embedded-kiddie/MLX90640/heatmap.h

#if   (N_HEATMAP == 256)
{
/* Railbow */
0x480F,0x400F,0x400F,0x400F,0x4010,0x3810,0x3810,0x3810,0x3810,0x3010,0x3010,0x3010,0x2810,0x2810,0x2810,0x2810,
0x2010,0x2010,0x2010,0x1810,0x1810,0x1811,0x1811,0x1011,0x1011,0x1011,0x0811,0x0811,0x0811,0x0011,0x0011,0x0011,
0x0011,0x0011,0x0031,0x0031,0x0051,0x0072,0x0072,0x0092,0x00B2,0x00B2,0x00D2,0x00F2,0x00F2,0x0112,0x0132,0x0152,
0x0152,0x0172,0x0192,0x0192,0x01B2,0x01D2,0x01F3,0x01F3,0x0213,0x0233,0x0253,0x0253,0x0273,0x0293,0x02B3,0x02D3,
0x02D3,0x02F3,0x0313,0x0333,0x0333,0x0353,0x0373,0x0394,0x03B4,0x03D4,0x03D4,0x03F4,0x0414,0x0434,0x0454,0x0474,
0x0474,0x0494,0x04B4,0x04D4,0x04F4,0x0514,0x0534,0x0534,0x0554,0x0554,0x0574,0x0574,0x0573,0x0573,0x0573,0x0572,
0x0572,0x0572,0x0571,0x0591,0x0591,0x0590,0x0590,0x058F,0x058F,0x058F,0x058E,0x05AE,0x05AE,0x05AD,0x05AD,0x05AD,
0x05AC,0x05AC,0x05AB,0x05CB,0x05CB,0x05CA,0x05CA,0x05CA,0x05C9,0x05C9,0x05C8,0x05E8,0x05E8,0x05E7,0x05E7,0x05E6,
0x05E6,0x05E6,0x05E5,0x05E5,0x0604,0x0604,0x0604,0x0603,0x0603,0x0602,0x0602,0x0601,0x0621,0x0621,0x0620,0x0620,
0x0620,0x0620,0x0E20,0x0E20,0x0E40,0x1640,0x1640,0x1E40,0x1E40,0x2640,0x2640,0x2E40,0x2E60,0x3660,0x3660,0x3E60,
0x3E60,0x3E60,0x4660,0x4660,0x4E60,0x4E80,0x5680,0x5680,0x5E80,0x5E80,0x6680,0x6680,0x6E80,0x6EA0,0x76A0,0x76A0,
0x7EA0,0x7EA0,0x86A0,0x86A0,0x8EA0,0x8EC0,0x96C0,0x96C0,0x9EC0,0x9EC0,0xA6C0,0xAEC0,0xAEC0,0xB6E0,0xB6E0,0xBEE0,
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
0xF6E8,0xF708,0xF709,0xF709,0xF709,0xF709,0xF729,0xF729,0xF729,0xF72A,0xF74A,0xF74A,0xF74A,0xF74A,0xF74A,0xF76A,
},
#else
#error  'N_HEATMAP' in 'MLX90649' needs to be set correctly
#endif
