embedded-kiddie/MLX90640/widgets.h

/*--------------------------------------------------------------------------------
 * Screen - Main
 *--------------------------------------------------------------------------------*/
// screen-main.png
// https://lang-ship.com/tools/image2data/
// RAW File Dump
static constexpr unsigned char screen_main[6105] = {
0x89, 0x50, 0x4e, 0x47, 0x0d, 0x0a, 0x1a, 0x0a, 0x00, 0x00, 0x00, 0x0d, 0x49, 0x48, 0x44, 0x52, 
0x00, 0x00, 0x01, 0x40, 0x00, 0x00, 0x00, 0xf0, 0x08, 0x02, 0x00, 0x00, 0x00, 0xfe, 0x4f, 0x2a, 
0x3c, 0x00, 0x00, 0x17, 0xa0, 0x49, 0x44, 0x41, 0x54, 0x78, 0x01, 0xec, 0x96, 0x31, 0xe8, 0xa9, 
0x61, 0x14, 0x87, 0xbf, 0x0b, 0x4c, 0xa4, 0x14, 0x83, 0x40, 0x14, 0x18, 0x45, 0x11, 0x22, 0x82, 
0x12, 0x16, 0x22, 0x83, 0xc5, 0xae, 0x14, 0xa4, 0xc4, 0x66, 0x1f, 0x59, 0x58, 0xd8, 0x94, 0x45, 
0x62, 0x90, 0x05, 0x7b, 0x89, 0x59, 0xca, 0x40, 0x0c, 0x10, 0x04, 0xf7, 0x57, 0xdf, 0x78, 0x97, 
0xff, 0xad, 0xbb, 0xdd, 0xf7, 0x19, 0xf4, 0x9e, 0x73, 0xce, 0x7b, 0x4c, 0xcf, 0x77, 0x5e, 0x8a, 
0x40, 0xf8, 0x7f, 0xf9, 0xc5, 0xa2, 0x18, 0x1c, 0xfa, 0xa8, 0xd1, 0x68, 0x1e, 0x8f, 0xc7, 0xf9, 
0x7c, 0xde, 0xef, 0xf7, 0xdf, 0xef, 0x17, 0x67, 0xa7, 0xd3, 0x49, 0xfd, 0x3d, 0x0e, 0x87, 0x03, 
0xd7, 0x7d, 0x3e, 0x1f, 0xf5, 0x07, 0x2a, 0x95, 0x6a, 0xb9, 0x5c, 0xba, 0xdd, 0x6e, 0x9c, 0x67, 
0xb3, 0xd9, 0x7c, 0x3e, 0xa7, 0x08, 0x04, 0xc2, 0x3f, 0x11, 0x58, 0xad, 0x56, 0x7f, 0x3e, 0x9f, 
0x62, 0xb1, 0xa8, 0x54, 0x2a, 0xe3, 0xf1, 0xf8, 0xfb, 0xfd, 0xae, 0x56, 0xab, 0xc8, 0xb3, 0x58, 
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
0x7f, 0xc8, 0x00, 0x61, 0x40, 0x6f, 0x99, 0x31, 0x81, 0xf7, 0x55, 0xa4, 0xff, 0xc5, 0x77, 0x00, 
0x33, 0xb5, 0xde, 0x79, 0x1a, 0x41, 0x67, 0x00, 0x00, 0x00, 0x00, 0x49, 0x45, 0x4e, 0x44, 0xae, 
0x42, 0x60, 0x82, };
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
