embedded-kiddie/MLX90640/marker.h

// icon-icon_marker0.png
// https://lang-ship.com/tools/image2data/
// RAW File Dump
static constexpr unsigned char icon_marker0[230] = {
0x89, 0x50, 0x4e, 0x47, 0x0d, 0x0a, 0x1a, 0x0a, 0x00, 0x00, 0x00, 0x0d, 0x49, 0x48, 0x44, 0x52, 
0x00, 0x00, 0x00, 0x0e, 0x00, 0x00, 0x00, 0x0e, 0x08, 0x00, 0x00, 0x00, 0x00, 0x3a, 0x23, 0x72, 
0x0d, 0x00, 0x00, 0x00, 0xad, 0x49, 0x44, 0x41, 0x54, 0x78, 0xda, 0x05, 0xc1, 0x3b, 0xd2, 0xc1, 
0x50, 0x00, 0x86, 0xe1, 0x37, 0xc1, 0x98, 0x64, 0x05, 0xfe, 0x8b, 0x0a, 0x85, 0x05, 0x30, 0x24, 
0x8d, 0x45, 0x88, 0xc9, 0x71, 0x06, 0x67, 0x23, 0x34, 0xd6, 0xa0, 0x61, 0x3f, 0x32, 0x6e, 0x05, 
0x85, 0xb0, 0x0a, 0x44, 0xef, 0xf3, 0x3c, 0x00, 0x54, 0x3b, 0xc6, 0x74, 0xab, 0x00, 0x00, 0xc9, 
0x59, 0x92, 0x2e, 0x09, 0x00, 0xcc, 0x75, 0x72, 0xed, 0xf6, 0xec, 0xa8, 0x05, 0xc0, 0x50, 0x9b, 
0x4a, 0xcd, 0x98, 0x5a, 0x79, 0xad, 0x04, 0x82, 0xeb, 0xa9, 0x92, 0x3c, 0xa4, 0xc7, 0xa8, 0x7c, 
0xcc, 0x03, 0x7a, 0xb2, 0x3f, 0xcf, 0xc3, 0x60, 0xb0, 0x7f, 0xfd, 0x8e, 0xd5, 0x63, 0xa2, 0xd6, 
0x44, 0x31, 0x44, 0x9a, 0x36, 0x35, 0xf5, 0x3d, 0xe4, 0xf1, 0x81, 0x0f, 0x9e, 0x80, 0xbe, 0xcc, 
0x5f, 0x91, 0xc5, 0xd1, 0xb6, 0xf8, 0x4f, 0x15, 0x11, 0xdc, 0xf6, 0x25, 0x5b, 0x48, 0x6f, 0x5b, 
0xda, 0xdd, 0x43, 0x48, 0xb5, 0xf2, 0xeb, 0xce, 0xd5, 0xfd, 0x95, 0x52, 0x80, 0xa5, 0x32, 0xd3, 
0x68, 0xa4, 0x99, 0x96, 0x00, 0x60, 0x73, 0x49, 0xca, 0x2d, 0x00, 0x40, 0x18, 0x3b, 0x17, 0x87, 
0x00, 0x5f, 0x62, 0xd3, 0x4c, 0x80, 0x38, 0x4d, 0x80, 0x4b, 0x00, 0x00, 0x00, 0x00, 0x49, 0x45, 
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
0x16, 0x32, 0x99, 0x85, 0x2b, 0xbd, 0x37, 0xc0, 0x37, 0xc7, 0x66, 0x42, 0x5f, 0x12, 0x5b, 0x0e, 
0xfe, 0x79, 0x3a, 0x4e, 0x4f, 0x3b, 0x3d, 0x7c, 0xfb, 0x04, 0x7f, 0xfb, 0x69, 0x12, 0x9f, 0xf2, 
0x94, 0x5a, 0x00, 0x00, 0x00, 0x00, 0x49, 0x45, 0x4e, 0x44, 0xae, 0x42, 0x60, 0x82, };
