embedded-kiddie/MLX90640/(commit log)

2025-02-01 Add arrow buttons on thermography screen.
2025-02-01 Add board type for CYD.
2025-02-02 Change I2C SDA/SCL pin assignment base on the pins_arduino.h
2025-02-04 Fix a bug where bilinear interpolation was not weighted correctly after changing resolution.
    [MLX90640.ino, mlx.hpp]
2025-02-10 Fix a bug of text size on calibration screen.
    [XPT2046_ScreenPoint.h]
2025-02-11 Fix SD card not working issue with TFT_eSPI.
    [MLX90640.ino, interpolation.hpp, pin_assign.h, sdcard.hpp, touch.hpp]
2025-02-11 Update files related calibration.
2025-02-20 Add prototype picture.
2025-02-27 Add DMA support definition.
2025-03-03 Fix an issue where the colors in screen capture images were shifted.
    [MLX90640.ino, sdcard.hpp]
2025-03-06 The touch filtering calculation has been changed from average to median, which prevents chattering of toggle switches.
    [XPT2046_ScreenPoint.h]
2025-04-06 Fix illegal path for SdFat.
    [sdcard.hpp]
2026-10-06 Fix: Fix: Resolved an issue where an exception interrupt occurred when accessing an empty SD card in File Explorer.
    [widgets.hpp]
